eltech-online/eltech-esp32-plant-monitor/(commit log)

2026-10-02 Plant monitor prototype: soil moisture + DHT11 + OLED + WiFi dashboard
    Compiles for ESP32-C3; not yet confirmed on real hardware.
2026-10-02 Add wiring diagram
2026-10-03 README: add tip on sealing the soil sensor with varnish
2026-10-06 Wiring diagram: redrawn, with every pin named and the modules' pins in their printed order
2026-10-14 Wiring diagram: add the BH1750 light sensor dome (lead order VCC, SCL, SDA, GND, ADDR left free)
2026-10-14 Add BH1750 light sensor with dome light correction (default x1.5, editable on the dashboard)
2026-10-14 Light correction: refuse invalid values; self-test tells 'bad reading' from 'not found'; README and comments brought up to date with the light sensor
2026-10-14 Add test sketches for the DHT11, light sensor and OLED; README: compile badge, out of beta
